clusterzx/Homelab-DIY-Case-NAS-ATX/stl/0_test_prints/test_insert_holes_1x.stl

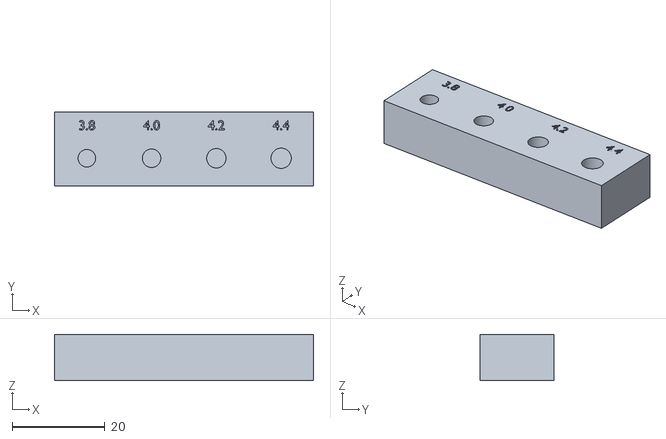
[picture p4: CAD file, 2026-10-21]
stl/0_test_prints/test_insert_holes_1x.stl
56.0 x 16.0 x 10.0
