clusterzx/Homelab-DIY-Case-NAS-ATX/stl/2_upper_module/side_left_upper_1x.stl

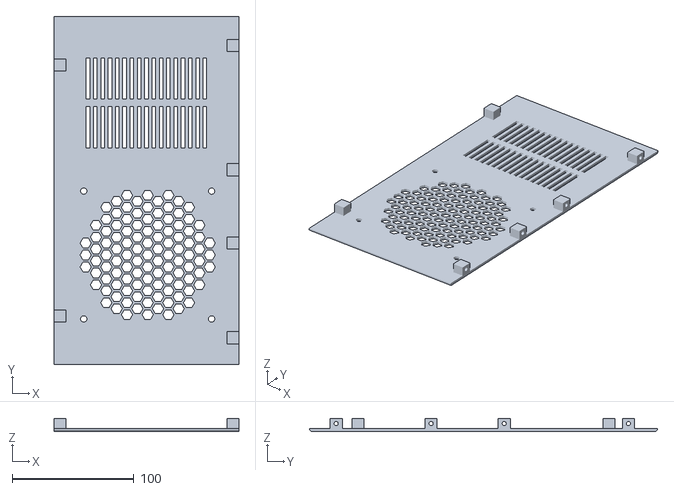
[picture p6: CAD file, 2026-10-21]
stl/2_upper_module/side_left_upper_1x.stl
152.0 x 286.0 x 10.4
