clusterzx/Homelab-DIY-Case-NAS-ATX/stl/3_drive_trays/ssd_tray_2x.stl

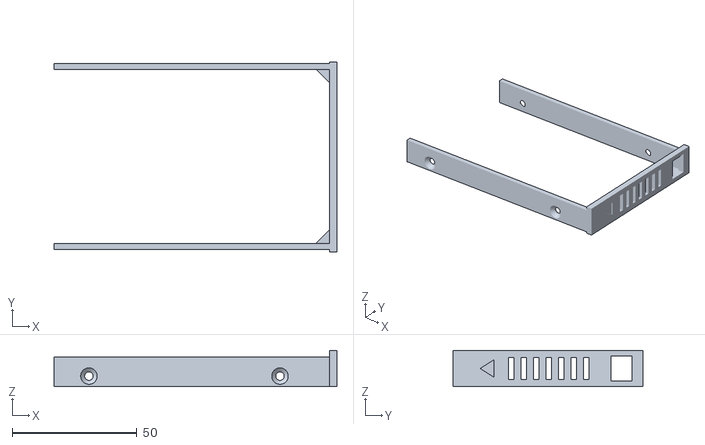
[picture p7: CAD file, 2026-10-21]
stl/3_drive_trays/ssd_tray_2x.stl
113.5 x 76.1 x 14.6
