clusterzx/Homelab-DIY-Case-NAS-ATX/stl/4_options/switch_bezel_1x.stl

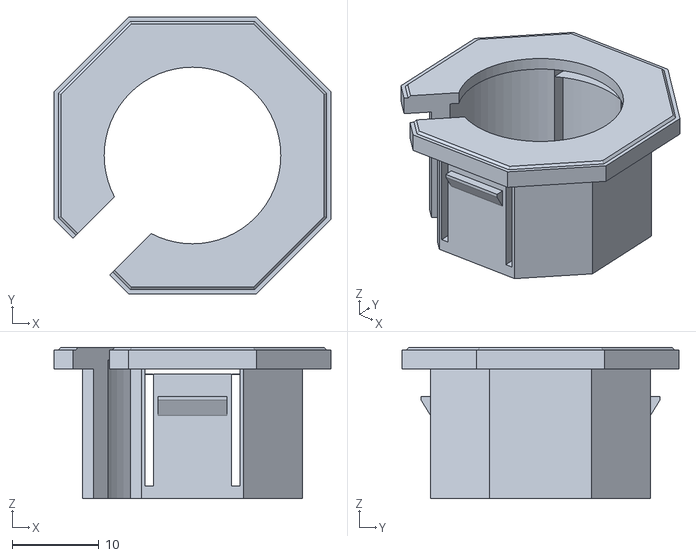
[picture p8: CAD file, 2026-10-21]
stl/4_options/switch_bezel_1x.stl
32.0 x 32.0 x 17.5
