clusterzx/Homelab-DIY-Case-NAS-ATX/stl/0_test_prints/test_io_shield_1x.stl

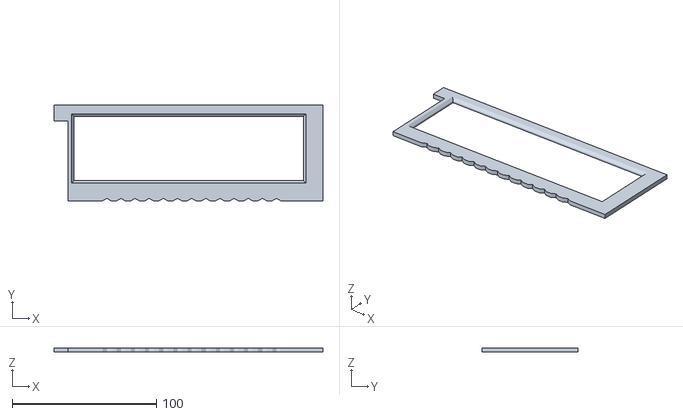
[picture p9: CAD file, 2026-10-21]
stl/0_test_prints/test_io_shield_1x.stl
186.4 x 66.2 x 3.00
