clusterzx/Homelab-DIY-Case-NAS-ATX/stl/1_lower_module/drive_tub_1x.stl

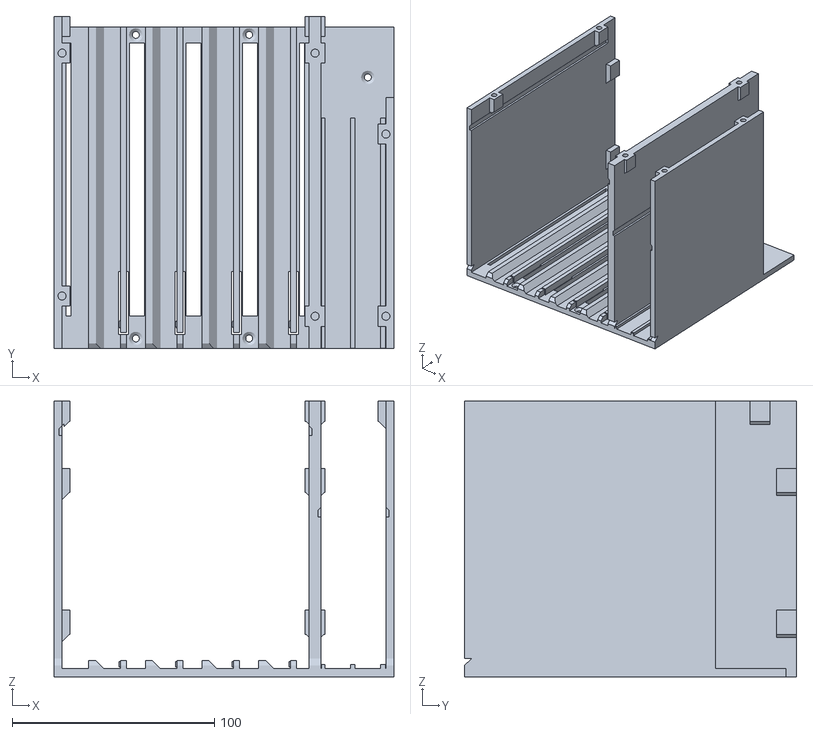
[picture p10: CAD file, 2026-10-21]
stl/1_lower_module/drive_tub_1x.stl
168.0 x 164.1 x 136.2
