clusterzx/Homelab-DIY-Case-NAS-ATX/stl/2_upper_module/slot_shelf_1x.stl

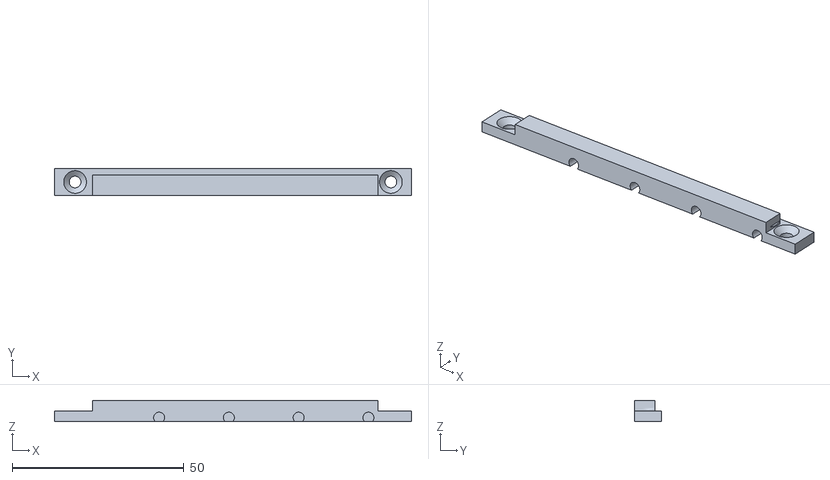
[picture p11: CAD file, 2026-10-21]
stl/2_upper_module/slot_shelf_1x.stl
104.0 x 8.00 x 6.12
