clusterzx/Homelab-DIY-Case-NAS-ATX/stl/3_drive_trays/hdd_tray_4x.stl

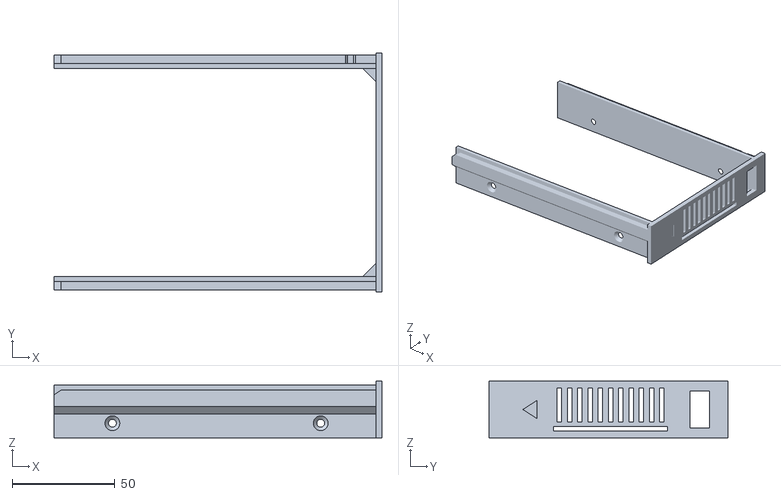
[picture p12: CAD file, 2026-10-21]
stl/3_drive_trays/hdd_tray_4x.stl
160.0 x 116.4 x 27.6
