clusterzx/Homelab-DIY-Case-NAS-ATX/stl/0_test_prints/gauge_hdd_1x.stl

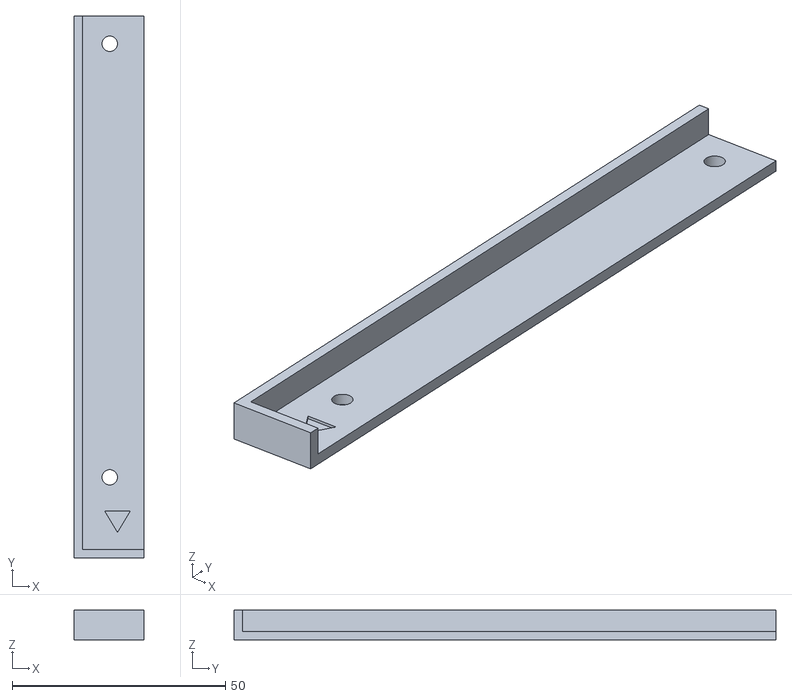
[picture p13: CAD file, 2026-10-21]
stl/0_test_prints/gauge_hdd_1x.stl
16.4 x 127.0 x 7.00
