clusterzx/Homelab-DIY-Case-NAS-ATX/stl/1_lower_module/rear_lower_1x.stl

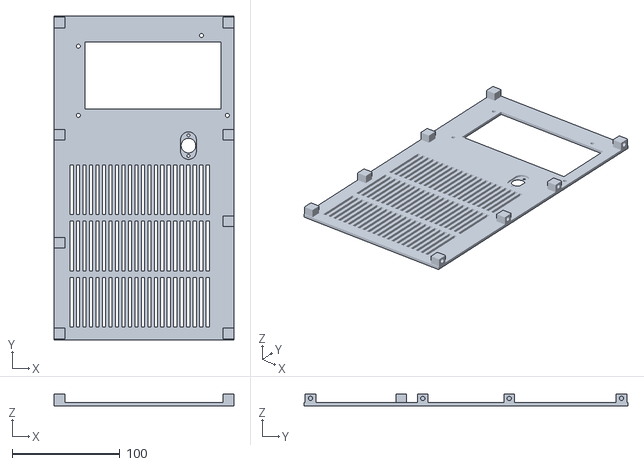
[picture p14: CAD file, 2026-10-21]
stl/1_lower_module/rear_lower_1x.stl
166.4 x 300.0 x 11.0
