clusterzx/Homelab-DIY-Case-NAS-ATX/stl/2_upper_module/rear_upper_1x.stl

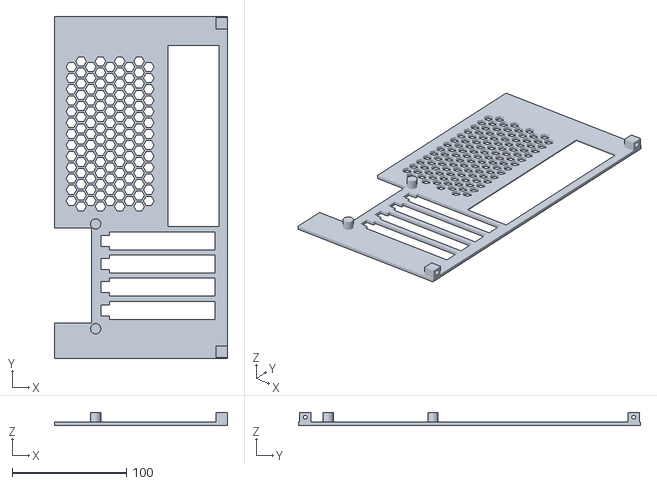
[picture p15: CAD file, 2026-10-21]
stl/2_upper_module/rear_upper_1x.stl
152.0 x 300.0 x 11.0
