clusterzx/Homelab-DIY-Case-NAS-ATX/stl/3_drive_trays/accent_strip_4x.stl

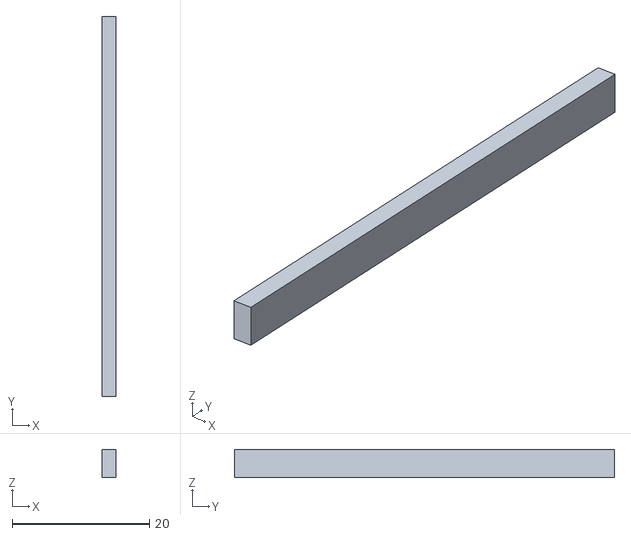
[picture p16: CAD file, 2026-10-21]
stl/3_drive_trays/accent_strip_4x.stl
2.00 x 55.4 x 4.10
