clusterzx/Homelab-DIY-Case-NAS-ATX/stl/0_test_prints/test_tray_channel_1x.stl

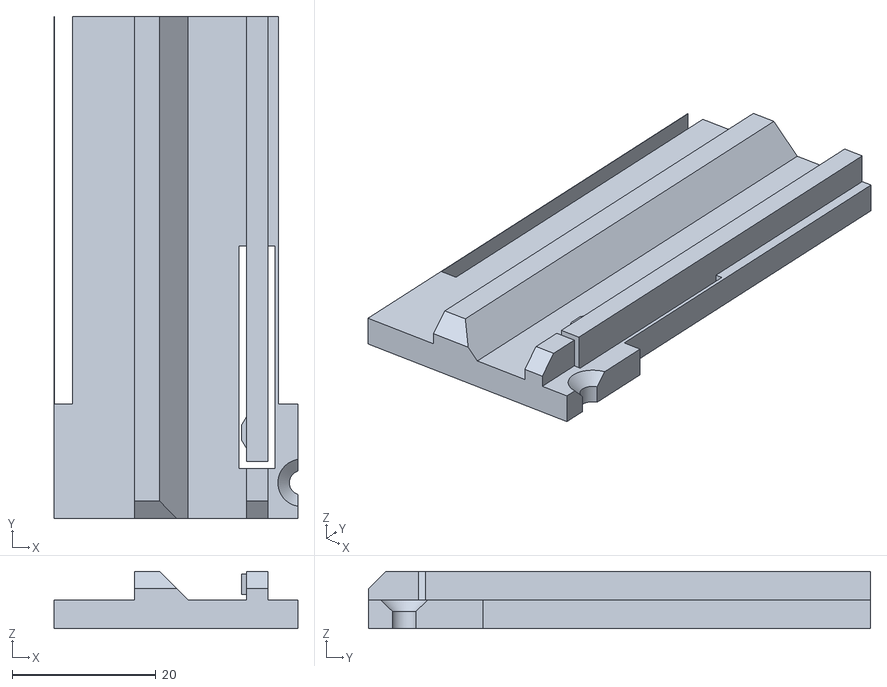
[picture p17: CAD file, 2026-10-21]
stl/0_test_prints/test_tray_channel_1x.stl
34.0 x 70.0 x 8.00
