clusterzx/Homelab-DIY-Case-NAS-ATX/stl/1_lower_module/drive_ceiling_1x.stl

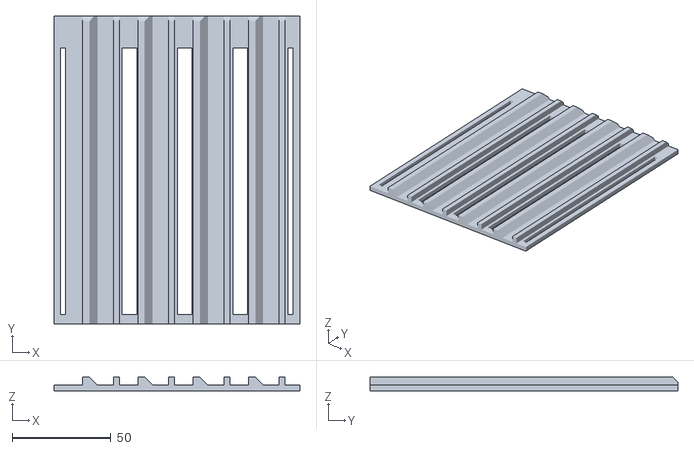
[picture p18: CAD file, 2026-10-21]
stl/1_lower_module/drive_ceiling_1x.stl
124.6 x 155.8 x 7.00
