clusterzx/Homelab-DIY-Case-NAS-ATX/stl/2_upper_module/display_bracket_1x.stl

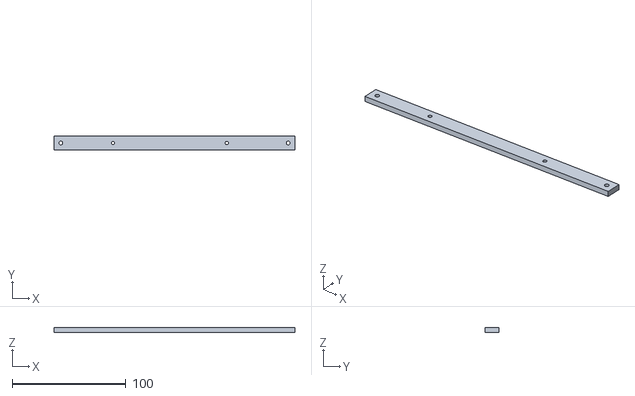
[picture p19: CAD file, 2026-10-21]
stl/2_upper_module/display_bracket_1x.stl
212.0 x 12.0 x 4.00
