clusterzx/Homelab-DIY-Case-NAS-ATX/stl/0_test_prints/gauge_ssd_1x.stl

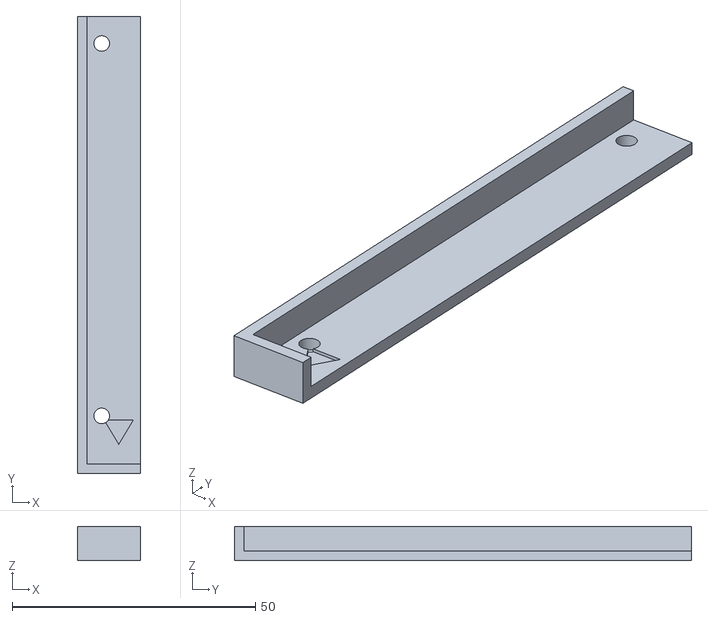
[picture p20: CAD file, 2026-10-21]
stl/0_test_prints/gauge_ssd_1x.stl
13.0 x 94.0 x 7.00
