clusterzx/Homelab-DIY-Case-NAS-ATX/stl/2_upper_module/front_upper_1x.stl

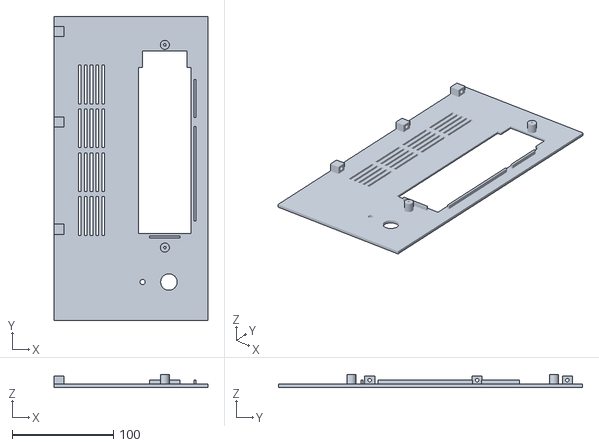
[picture p21: CAD file, 2026-10-21]
stl/2_upper_module/front_upper_1x.stl
152.0 x 300.0 x 12.4
