clusterzx/Homelab-DIY-Case-NAS-ATX/stl/1_lower_module/foot_4x.stl

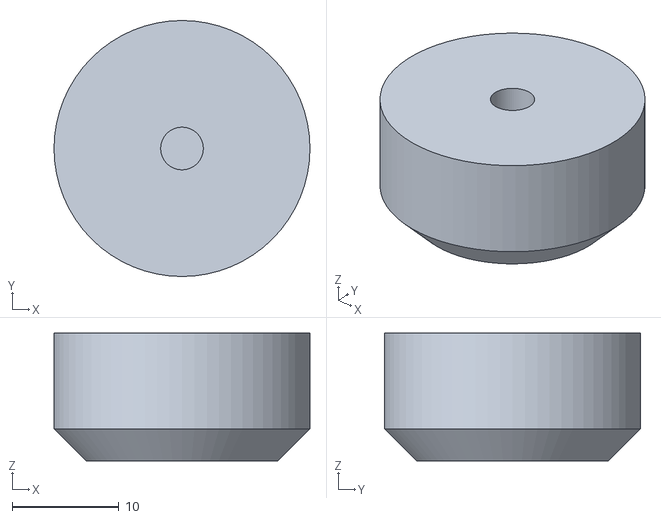
[picture p22: CAD file, 2026-10-21]
stl/1_lower_module/foot_4x.stl
24.0 x 24.0 x 12.0
