clusterzx/Homelab-DIY-Case-NAS-ATX/stl/2_upper_module/top_plate_1x.stl

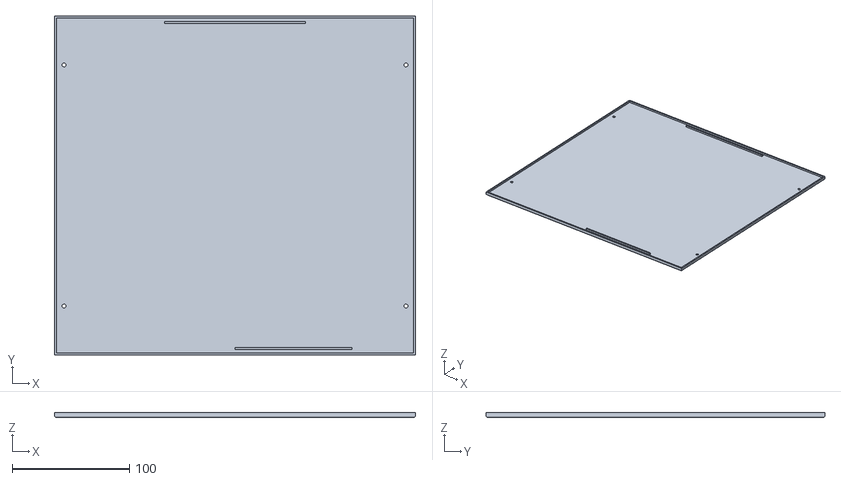
[picture p23: CAD file, 2026-10-21]
stl/2_upper_module/top_plate_1x.stl
308.3 x 289.5 x 4.40
