clusterzx/Homelab-DIY-Case-NAS-ATX/stl/1_lower_module/backplane_holder_1x.stl

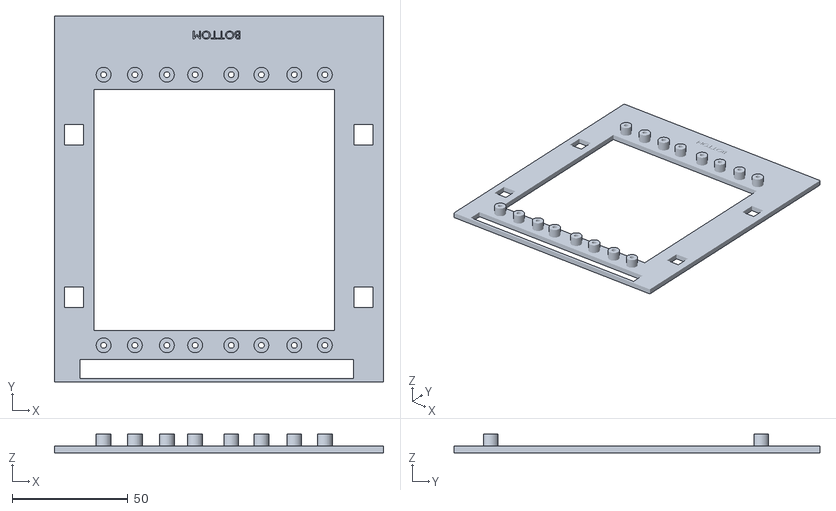
[picture p24: CAD file, 2026-10-21]
stl/1_lower_module/backplane_holder_1x.stl
142.0 x 157.9 x 8.00
