clusterzx/Homelab-DIY-Case-NAS-ATX/stl/2_upper_module/slot_cover_1x.stl

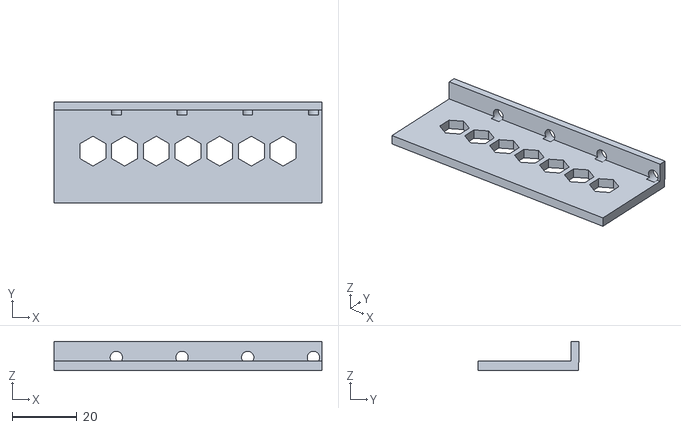
[picture p25: CAD file, 2026-10-21]
stl/2_upper_module/slot_cover_1x.stl
82.9 x 31.2 x 9.12
