clusterzx/Homelab-DIY-Case-NAS-ATX/stl/1_lower_module/bottom_plate_1x.stl

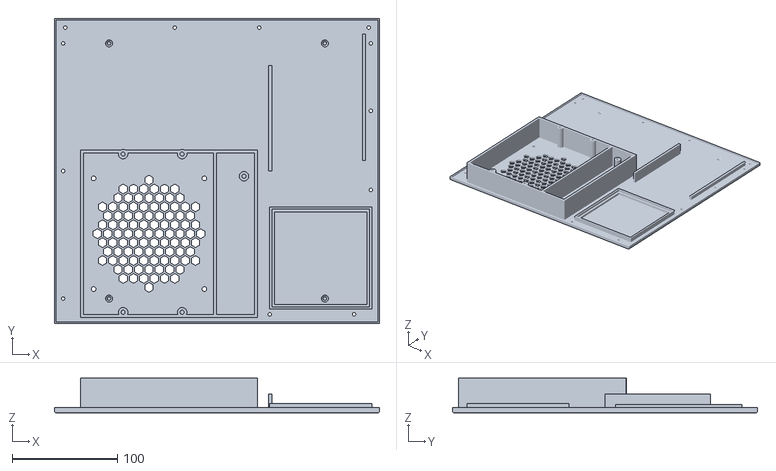
[picture p26: CAD file, 2026-10-21]
stl/1_lower_module/bottom_plate_1x.stl
308.3 x 289.5 x 33.0
