clusterzx/Homelab-DIY-Case-NAS-ATX/stl/2_upper_module/mid_plate_1x.stl

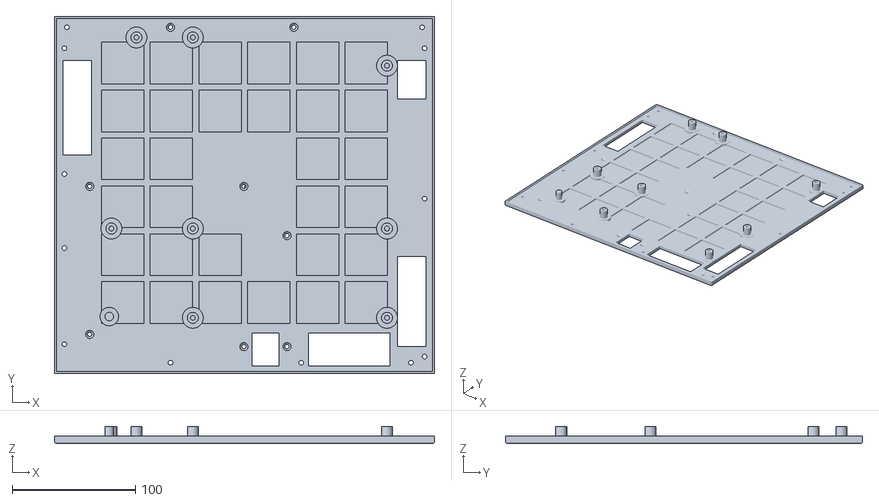
[picture p28: CAD file, 2026-10-21]
stl/2_upper_module/mid_plate_1x.stl
308.3 x 289.5 x 14.0
