clusterzx/Homelab-DIY-Case-NAS-ATX/stl/1_lower_module/backplane_brace_2x.stl

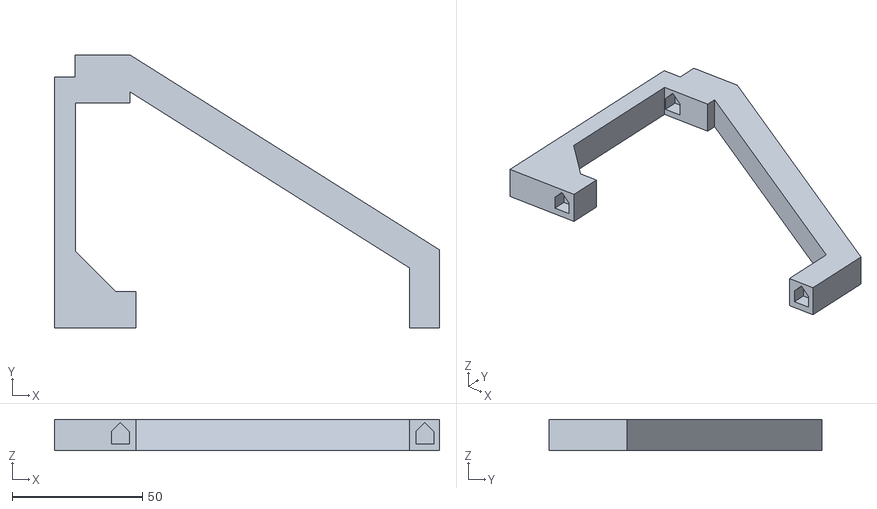
[picture p29: CAD file, 2026-10-21]
stl/1_lower_module/backplane_brace_2x.stl
147.7 x 104.8 x 12.0
