clusterzx/Homelab-DIY-Case-NAS-ATX/stl/1_lower_module/ssd_ceiling_1x.stl

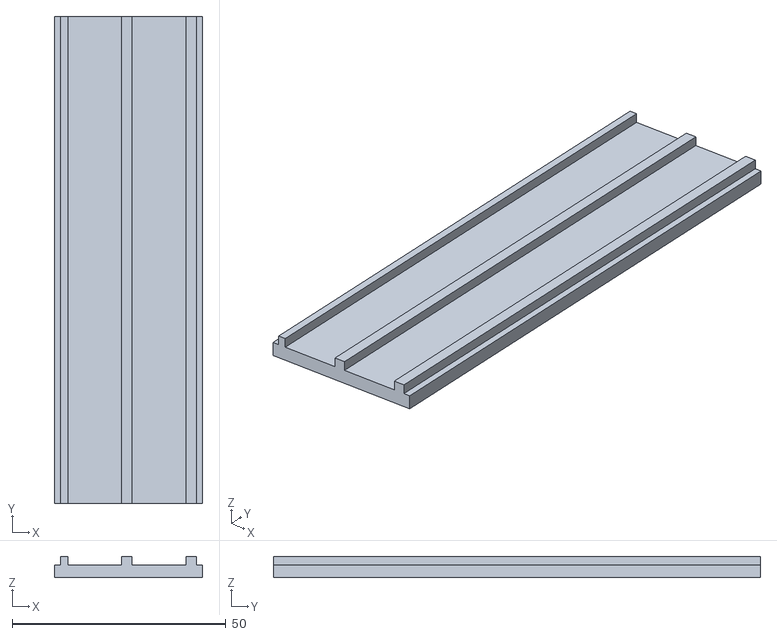
[picture p30: CAD file, 2026-10-21]
stl/1_lower_module/ssd_ceiling_1x.stl
34.6 x 113.9 x 5.00
