clusterzx/Homelab-DIY-Case-NAS-ATX/stl/1_lower_module/side_right_lower_1x.stl

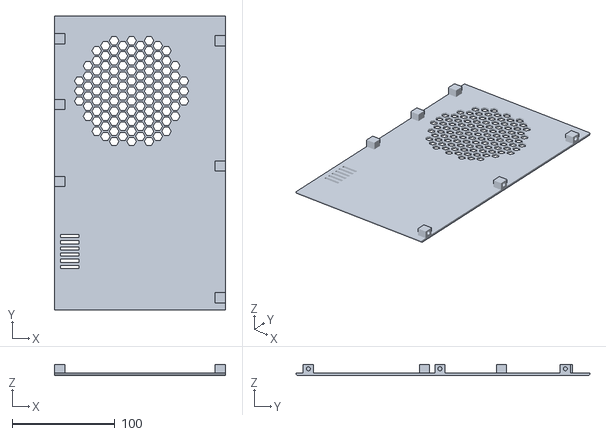
[picture p31: CAD file, 2026-10-21]
stl/1_lower_module/side_right_lower_1x.stl
166.4 x 286.0 x 10.4
