clusterzx/Homelab-DIY-Case-NAS-ATX/(list of files, cad)

Other CAD files:
stl/2_upper_module/side_right_upper_1x.stl
stl/1_lower_module/clamp_washer_4x.stl
